arnljot/dataflyer2650/BOM.csv

Reference | Quantity | Description | Manufacturer | MPN | Mouser PN | DigiKey PN | Approx Price
J1 | 1 | 26-pin (2x13) 2.54mm female socket, PCB mount, vertical, through-hole | Sullins | PPPC132LFBN-RC | N/A | S7116-ND | $1.50
J1 | 1 | 26-pin (2x13) 2.54mm female socket, PCB mount, vertical, through-hole (Mouser-available alternative). 10µin gold/matte tin tails, 2A rating | 3M | 929852-01-13-RA | 517-929852-01-13-RA | 19-929852-01-13-RA-ND | $1.80
J1 (alt) | 1 | Alternative J1 (for Phase5 Blizzard IV SCSI kit): 26-pin (2x13) 2.54mm female socket, right-angle, through-hole. Drop-in for J1 footprint (drill ≥1.02mm) | Sullins | PPPC132LJBN-RC | N/A | S5566-ND | $1.90
J1 (alt) | 1 | Alternative J1 (for Phase5 Blizzard IV SCSI kit, Mouser-available): 26-pin (2x13) 2.54mm female socket, right-angle, through-hole. Machined-pin, gold mating/tin tail plating, 3A rating | Preci-dip | 803-87-026-20-001101 | 437-8038702620001101 | 803-87-026-20-001101-ND | $6.00
J2 | 1 | 50-pin (2x25) 2.54mm shrouded male IDC header, vertical, PCB mount | 3M | N2550-6002-RB | 517-N2550-6002RB | MHC50K-ND | $3.00
PCB | 1 | 2-layer PCB, ~73.5x35mm, 1.6mm FR4, HASL or ENIG finish | JLCPCB/PCBWay | N/A | N/A | N/A | $1.50
