arnljot/dataflyer2650/(list of files, drawings)

Other design files:
dataflyer-2650.dsn
