arnljot/dataflyer2650/dataflyer-2650.kicad_sch

## KiCad design dataflyer-2650.kicad_sch (2026-06-02)

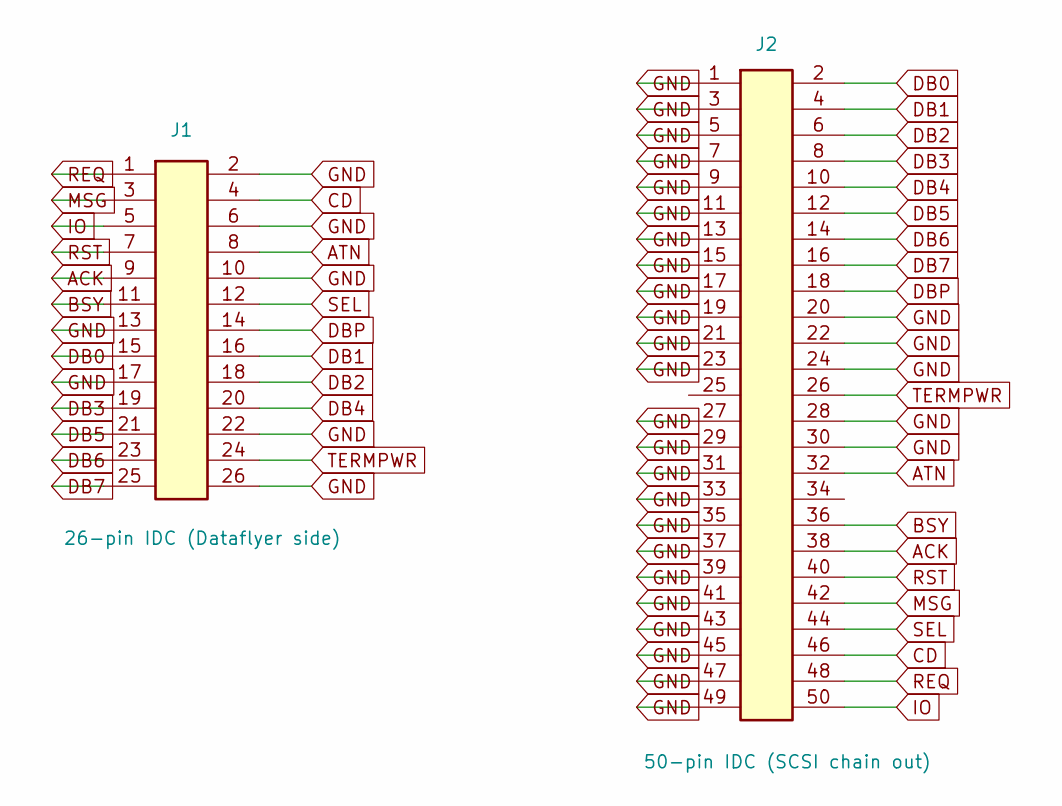
[picture p1: schematic dataflyer-2650.kicad_sch]

Parts:
J1: 26-pin IDC (Dataflyer side); PinSocket_2x13_P2.54mm_Vertical
J2: 50-pin IDC (SCSI chain out); IDC-Header_2x25_P2.54mm_Vertical

Connections:
ACK: J1.9, J2.38
ATN: J1.8, J2.32
BSY: J1.11, J2.36
CD: J1.4, J2.46
DB0: J1.15, J2.2
DB1: J1.16, J2.4
DB2: J1.18, J2.6
DB3: J1.19, J2.8
DB4: J1.20, J2.10
DB5: J1.21, J2.12
DB6: J1.23, J2.14
DB7: J1.25, J2.16
DBP: J1.14, J2.18
GND: J1.2, J1.6, J1.10, J1.13, J1.17, J1.22, J1.26, J2.1, J2.3, J2.5, J2.7, J2.9, J2.11, J2.13, J2.15, J2.17, J2.19, J2.20, J2.21, J2.22, J2.23, J2.24, J2.27, J2.28, J2.29, J2.30, J2.31, J2.33, J2.35, J2.37, J2.39, J2.41, J2.43, J2.45, J2.47, J2.49
IO: J1.5, J2.50
MSG: J1.3, J2.42
REQ: J1.1, J2.48
RST: J1.7, J2.40
SEL: J1.12, J2.44
TERMPWR: J1.24, J2.26
