arnljot/dataflyer2650/(commit log)

2026-06-02 Initial commit: Dataflyer 2650 (rev 1.0)
    KiCad 10 project files, schematic, PCB layout, BOM, pinout reference,
    and CERN-OHL-S-2.0 license.
    (c) 2026 Arnljot Arntsen
    [BOM.csv, dataflyer-2650.dsn, dataflyer-2650.kicad_pcb, dataflyer-2650.kicad_sch]
2026-06-02 Docs: project name, brand casing, license refs, and generalization
    README, PINOUT, LICENSE:
    - Use "DataFlyer 2650" as the project name in titles (was the host
    card name, "Dataflyer 1200 SCSI+")
    - Normalize brand to CamelCase "DataFlyer" per Expansion Systems'
    manual convention
    - Add LICENSE.md and CERN-OHL-S-2.0.txt to README's Files list
    - Fix broken LICENSES path in LICENSE.md to ./CERN-OHL-S-2.0.txt
    README:
    - Note that with a 90° angled connector the adapter also works with
    the Phase5 Blizzard IV SCSI kit
    - Generalize J1 description and ASCII caption to "SCSI controller
    card" instead of DataFlyer-specific wording
    - Add connector gender to J1/J2 bullets (female / male shrouded)
    -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
2026-06-02 BOM: add Sullins PPPC132LJBN-RC as alternative J1 for Blizzard
    Right-angle counterpart to the vertical J1 (PPPC132LFBN-RC) in the
    same Sullins PPPC family. Same 2x13 through-hole footprint, same pin
    geometry, recommended drill 1.02 mm — drop-in without PCB changes.
    Enables using the adapter with a Phase5 Blizzard IV SCSI kit instead
    of the DataFlyer 1200 SCSI+.
    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
    [BOM.csv]
2026-06-02 BOM: fix DigiKey PN for J1 (S7042-ND → S7116-ND)
    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
    [BOM.csv]
2026-06-02 BOM: fix part numbers for J2
    - MPN: N2550-6V02-RB-WF → N2550-6002-RB
    - Mouser: 517-N2550-6V02RB → 517-N2550-6002RB
    - DigiKey: 3M156175-ND → MHC50K-ND
    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
    [BOM.csv]
2026-06-02 BOM: correct PCB dimensions to ~73.5x35mm
    Measured from Edge.Cuts in dataflyer-2650.kicad_pcb. Width was listed
    as ~50mm but the actual board outline is 73.5mm wide (needed for the
    2x25 50-pin shrouded header on J2).
    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
    [BOM.csv]
2026-06-02 BOM: remove Mouser PN for both J1 variants (not stocked at Mouser)
    Sullins PPPC132LFBN-RC and PPPC132LJBN-RC are not available at Mouser
    (verified via search). DigiKey is the primary distributor for both.
    The previous "649-" prefix was an incorrect guess on my part — that
    prefix is for Greenlee, not Sullins.
    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
    [BOM.csv]
2026-06-02 BOM: add 3M 929852-01-13-RA as Mouser-available alternative for J1
    Drop-in vertical equivalent of the Sullins PPPC132LFBN-RC:
    - Same 2x13 @ 2.54mm through-hole footprint, same recommended drill
    (Ø1.02mm) per 3M datasheet TS-0815-E
    - Pin tails 0.41x0.76mm rectangular (Sullins is 0.40x0.60 — fits same
    PCB holes)
    - 10µin gold mating with matte tin tails (-RA suffix is a plating
    code in 3M 929 series, NOT right-angle)
    - 2A current rating (vs 3A Sullins) — fine for SCSI signaling
    - Distributors: Mouser 517-929852-01-13-RA, DigiKey 19-929852-01-13-RA-ND
    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
    [BOM.csv]
2026-06-02 BOM: add Preci-dip 803-87-026-20-001101 as Mouser-available J1 (alt)
    Right-angle female socket equivalent of Sullins PPPC132LJBN-RC,
    available on Mouser. Verified via DigiKey sibling part 803-87-010-20-
    001101: the "-20-" code in this 803-87-XXX-20-001101 family denotes
    right-angle orientation. 26-pin (2x13) 2.54mm pitch, machined-pin
    construction, gold/tin plating, 3A rating.
    - Mouser: 437-8038702620001101
    - DigiKey: 803-87-026-20-001101-ND
    - Approx price $6 (Preci-dip is premium machined-pin, verify locally)
    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
    [BOM.csv]
2026-06-02 Release 1.1: GND reserved IDC50 pins; J1 moved inboard
    Schematic: connect SCSI-1 reserved IDC50 pins 20, 22, 24, 28, 30, 34
    to GND for cleaner signaling and to match common SCSI-1 controller
    practice (these were left floating in 1.0).
    PCB: J1 shifted ~3.5 mm inboard for easier routing. Board outline
    (73.5 x 35 mm) and connector mating are unchanged — does not affect
    fit with DataFlyer 1200 SCSI+ or Phase5 Blizzard IV SCSI kit.
    Docs: README revision history, PINOUT.md IDC50 ground net section.
    KiCad schematic rev bumped 1.0 -> 1.1 (PCB internal rev left at 1.8).
    Freerouting artifacts (.dsn/.ses/.rules) re-exported.
    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
    [dataflyer-2650.dsn, dataflyer-2650.kicad_pcb, dataflyer-2650.kicad_sch]
2026-06-02 Docs/KiCad: sync schematic title, PCB rev, and PINOUT references
    - Schematic title: "Dataflyer 1200 SCSI+ 26pin to 50pin Adapter"
    -> "DataFlyer 2650 — 26-pin to 50-pin SCSI Adapter"
    - PCB rev: 1.8 -> 1.1 (sync with schematic and README revision history)
    - PINOUT.md: add cdmediaworld.com 50-pin SCSI-1 pinout reference
    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
    [dataflyer-2650.kicad_pcb, dataflyer-2650.kicad_sch]
2026-06-02 KiCad: fix brand casing in schematic comment 1 (Dataflyer -> DataFlyer)
    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
    [dataflyer-2650.kicad_sch]
2026-06-02 PINOUT: reorder mapping table columns to Signal first
    New column order: Signal | IDC26 pin | IDC50 pin | DB25 pin.
    Putting the signal first makes the table easier to scan when looking
    up which pins carry a given signal; DB25 moves to the end as the
    historical/standards reference.
    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
2026-06-02 Add Gerbers and drill file for v1.1 production submission
    Gerbers exported from KiCad for the v1.1 design (GND-pin bugfix +
    J1 inboard shift). Bundled zip (dataflyer-2650-v1.1.zip) submitted
    to PCBWay for first-prototype production.
    UNTESTED: theoretical functionality only — DMM checks and real-
    hardware verification on DataFlyer 1200 SCSI+ / Phase5 Blizzard IV
    SCSI kit still pending.
    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
    [dataflyer-2650-B_Cu.gbr, dataflyer-2650-B_Mask.gbr, dataflyer-2650-B_Paste.gbr, dataflyer-2650-B_Silkscreen.gbr, dataflyer-2650-Edge_Cuts.gbr, dataflyer-2650-F_Cu.gbr, dataflyer-2650-F_Mask.gbr, dataflyer-2650-F_Paste.gbr]
2026-06-02 1.1.1: project text variables + silkscreen overhaul + J1 pin 1 marker
    Project text variables (.kicad_pro):
    - BOARD_NAME = "DataFlyer 2650 — 26-pin to 50-pin SCSI Adapter"
    - BOARD_REV = "1.1.1"
    - sch_revision now references ${BOARD_REV}
    - Plot output directory set to gerbers/
    Schematic (.kicad_sch):
    - title and rev fields now reference ${BOARD_NAME} / ${BOARD_REV}
    so the project text variables are the single source of truth
    PCB (.kicad_pcb):
    - Board-level BOARD_NAME and BOARD_REV properties added
    - Front silkscreen overhauled:
    * Board name now uses ${BOARD_NAME} (fixes lingering lowercase
    "Dataflyer 2650 SCSI Adapter" instance)
    * Added "Rev ${BOARD_REV}" line
    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
    [dataflyer-2650.kicad_pcb, dataflyer-2650.kicad_sch]
2026-06-02 README: add 1.1.1 to revision history
    Missed this in commit 8694d0e. Captures the silkscreen overhaul and
    J1 pin 1 marker; notes that 1.1.1 is electrically identical to 1.1
    and not formally released per the policy.
    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
2026-06-11 1.2: reverse-L board outline that wraps around the Blizzard SCSI kit
    The rectangular 1.1/1.1.1 outline would not clear a wedge Amiga 1200
    fitted with a Phase5 Blizzard accelerator. The board has been reshaped
    to a reverse-L outline (79.05 x 26.01 mm) that wraps around the Blizzard
    SCSI kit: a full-width top band carries the 50-pin J2, the board extends
    down only on the right to form a tab carrying the 26-pin J1, and the
    lower-left corner is removed.
    Fit reasoning:
    - J2 (50-pin) is pushed further toward the rear of the A1200 to keep the
    SCSI cable clear of the keyboard where the case tapers to the front.
    - For DataFlyer 1200 SCSI+ mounting, the area to the left of the 26-pin
    connector (t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
    [dataflyer-2650-B_Cu.gbr, dataflyer-2650-B_Mask.gbr, dataflyer-2650-B_Paste.gbr, dataflyer-2650-B_Silkscreen.gbr, dataflyer-2650-Edge_Cuts.gbr, dataflyer-2650-F_Cu.gbr, dataflyer-2650-F_Mask.gbr, dataflyer-2650-F_Paste.gbr]
2026-06-11 1.2.1: drive PCB title block from project text variables
    The PCB title block still carried the stale 1.1 export values (rev
    "1.1", a "Dataflyer/Blizzard ... (T-shape)" title and matching comment).
    KiCad derives the Gerber metadata from these fields, so the exported
    .gbrjob ProjectId revision and the per-file TF.ProjectId lines reported
    revision 1.1 even though the printed silkscreen showed Rev 1.2 (driven
    by ${BOARD_REV}).
    Title block now references the project text variables:
    - title -> ${BOARD_NAME}
    - rev -> ${BOARD_REV}
    - date and comment 1 refreshed (comment now describes the reverse-L
    outline accurately)
    BOARD_REV bumped to 1.2.1 in .kicad_pro and the board-level property.
    The tex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
    [dataflyer-2650.kicad_pcb]
2026-06-11 README: redraw physical-design diagram for the reverse-L layout
    The ASCII diagram still showed the old rectangular 1.0/1.1 placement
    (J1 above J2). Redraw it to match the 1.2 reverse-L outline: the 50-pin
    J2 sits across the full-width top band, the 26-pin J1 sits in the
    lower-right tab, and the lower-left corner is removed.
    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
2026-06-11 1.3: match front/back board outline (overlapping step edges)
    In 1.2 the front and back board-edge outlines did not match: the two
    horizontal step edges that run parallel to the connectors did not
    overlap between the F and B sides. The lower-right tab edge has been
    corrected so both sides now share the same outline.
    No schematic or pinout change - electrically identical to 1.2, same
    reverse-L design. Gerbers + drill re-exported from KiCad 10.0.3; the
    metadata now correctly reports revision 1.3 (the 1.2.1 title-block fix
    is now reflected in the exported files).
    BOARD_REV bumped to 1.3. Bundled zip (dataflyer-2650-v1.3.zip) prepared
    for PCBWay. README revision history updated; Files section r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
    [dataflyer-2650-B_Cu.gbr, dataflyer-2650-B_Mask.gbr, dataflyer-2650-B_Paste.gbr, dataflyer-2650-B_Silkscreen.gbr, dataflyer-2650-Edge_Cuts.gbr, dataflyer-2650-F_Cu.gbr, dataflyer-2650-F_Mask.gbr, dataflyer-2650-F_Paste.gbr]
2026-06-11 1.4: manual route to fix unconnected J1 pin 22; document DataFlyer mirror
    PCBWay flagged that J1 pin 22 was not connected on the 1.3 board. The
    board has been manually routed to close the gap. Board now measures
    ~79 x 27 mm (reverse-L outline with a small lower-left cut-out).
    Newly documented incompatibility: the Expansion Systems DataFlyer 1200
    SCSI+ presents its 26-pin header mirrored relative to the Phase5
    Blizzard - the pinout is identical, but the odd-pin and even-pin rows
    are swapped. The board is routed for the Blizzard orientation and will
    NOT work with the DataFlyer without rework. A compatibility note has
    been added to the top of the README.
    Test status corrected: only v1.1 has b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
    [dataflyer-2650-B_Cu.gbr, dataflyer-2650-B_Mask.gbr, dataflyer-2650-B_Paste.gbr, dataflyer-2650-B_Silkscreen.gbr, dataflyer-2650-Edge_Cuts.gbr, dataflyer-2650-F_Cu.gbr, dataflyer-2650-F_Mask.gbr, dataflyer-2650-F_Paste.gbr]
2026-06-12 README: retract DataFlyer mirrored-pinout claim
    The earlier note that the DataFlyer 1200 SCSI+ presented a mirrored
    26-pin pinout (odd/even rows swapped) and would need rework came from an
    out-of-date NCR5380 datasheet. The correct datasheet for the 44-pin PLCC
    package matches the Blizzard pinout, verified with a multimeter against
    the 26-pin header. The DataFlyer and Blizzard share the same pinout, so
    the board works with both - no rework needed.
    Removed the mirror/rework references from the top compatibility note and
    the 1.4 revision-history entry; kept the hardware test status (only v1.1
    bench-tested).
    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
