arnljot/dataflyer2650/(notices)

Notices in the files:
dataflyer-2650.kicad_sch:
©2026 Arnljot Arntsen , license: CERN-OHL-S-2.0
